Batperson/clock/notes.txt

20/10/2019
There is a high-frequency whine from the audio. This changes in frequency with the length of the
audio sample buffer, so there is likely a glitch when populating the buffer.

There is an audible glitch every 1 seconds, it is caused by the RTC interrupt.

Currently using 150 ohm / 0.1 uF RC low pass filter. HF PWM is attenuated to around 0.1V.

29/10/2019
Implemented button firmware. IDR value is always 1 for all buttons.

02/11/2019
Buttons are working correctly now. Needed to add pull-down resistors even though I specified internal pulldown resistors.

03/11/2019
Implemented a beep routine for button press. This is working but a hard fault occurs if the beep is triggered
by a long button press while a song is playing.

12/11/2019
160 * 128 bare TFT with 14-pin flex connector. Maybe glue directly to outside of enclosure?
Pinout:
1  NC
2  VSS		connect to GND
3  LED-		connect to GND
4  LED+		connect to 3V3 (LED backlight. Resistor needed?)
5  VSS		connect to GND
6  /RESET	reset active low
7  A0		data/command for 4-wire SPI
8  SDA		serial data, MOSI
9  SCK		serial clock
10 VDDA		connect to 3V3 (analog supply)
11 VDDIC	connect to 3V3 (VDDIO? digital supply)
12 /CS		chip select active low
13 VSS		connect to GND
14 NC

13/11/2019
Free shipping to Dec 31 for Element14 with I'MINVITEDFORFREESHIPPING in special instructions/other in delivery options. Order amplifier ICs.
Bomb disarming puzzle in suitcase: https://imgur.com/a/8nmzieA

17/11/2019
Clock set functionality working. Counter does not update immediately.
Next tasks:
* Implement a menu timeout to play an alarm song if the menu option is selected for 1 sec
* Implement a centre-align text render

Audio output has an unpleasant whine. The whine is reduced if LoadSoundBuffer returns early, and goes away entirely if the sound buffer
contains only zeroes. It shows on the oscilloscope as a square wave.
The whine is present on the VCC line so most likely digital noise.
The click which occurs every second when the screen refreshes is also present asa voltage drop on VCC.
The whine is most likely caused by voltage fluctuations which occur as interrupts change the demand for current.
It is mitigated by removing the __WFI() line (i.e. disabling sleep until interrupt) and by placing a 220uF cap
across VCC / GND.

18/11/2019
Now possible to preview an alarm ring by highlighting it in the alarm menu, it will play after 1.5 secs.

26/11/2019
Revised the button system.
Now an issue where the same button events repeat, if the button handlers are changed (e.g. when displaying a menu).
Fixed the button issue.
Seems to be a memory corruption problem, where song state is being overwritten.

30/11/2019
There was no memory corruption, but because I had not declared some variables static but given them the same name across different code units, the linker
made them share the same memory location. Problem is fixed now.

21/12/2019
Most functionality now working. Time and date can be set. Alarm can be set. User must enter an unlock sequence to stop the alarm, this will be an option they can select.
Next tasks to complete:
* The FillMargin flag for DrawText currently assumes text is centred vertically & horizontally
* Special Day messages need to be implemented
* About screen needs to be implemented
* Too much voltage drop causing screen to go dark, and blinking when rendering
* Need to support save/restore of settings in backup domain

23/12/2019
Save/restore settings implemented.
A hard fault is occurring when doing sample playback of alarm rings in the menu. 
Special Days functionality appears to be activating at incorrect times and showing garbage.

24/12/2019
Special Day messages now appearing. Some screen garbage and incorrect colours are likely the result of re-entrancy between the render callback which fires every second
and the special day banner callback which fires every 120ms.

27/12/2019
Re-entrancy issue fixed. Next task is to fix the hard fault when doing sample playback of alarm rings.

03/01/2019
Fully implemented FillMargin behaviour

08/01/2019
Implemented alarm, snooze and no-alarm icons.
Hard fault during sample playback fixed. 
Sometimes, sample playback initiates twice in succession. Sample playback does not start when first showing
the alarm ring menu.

11/01/2019
Fixed the double-playback of alarm rings when previewing in the menu.
Added new ring: Baby Shark.

19/01/2019
Added a few new songs, for use as easter eggs.
Implemented an audio amplifier + speaker, using the TPA2005D1 audio amplifier IC from Texas Instruments. Amplifier shutdown now controlled from pin A2. Unfortunately this creates pop
so it's not possible to switch the amp on and off before playing sounds.
Note intervals now 16 bits long for tied semibreves.
New clipped sine voice, sounds better than boring pure sine tone.

22/01/2019
Next tasks:
* Revamp alarm behaviour. Do not leave alarm mode when snoozing. Make the time flash random coloured stripes and show a ringing bell.
  Long-press any button to snooze.
  Short-press any button to exit alarm mode if alarm lock not set. If set, user must short-press the displayed sequence.
* New menu option: random alarm ring.
* New menu option: adjust the RTC oscillator trim register in case clock is slow or fast.
* New menu option: select display colour.
* New menu option: master volume for alarm ring
* Implement the About screen.   
* Add some more songs. Include Into The Unknown and Star Wars.

27/01/2019
After a song has been stopped, PlaySong does not start a new song playing.

02/02/2020
Finally begun implementing the About screen, which will mostly display a bitmap with a brush effect.
Bitmap is not currently rendering correctly, pixels are skewed.

04/02/2020
About screen now displaying correctly, with a moving gradient brush.
On startup, some random noise gets written to the left and right of the screen. Suspect this may be due to re-entrancy when the display init
routine gets called while the bitmap is already rendering.

08/02/2020
Only one mode now used to set all fields including date, clock, alarm and calibration.
Noticed that switching out of About mode leaves some garbage on the screen.

11/02/2020
Measured current draw. It was 70-80mA with the menu open, and 90 - 120mA with a song playing.

15/02/2020
Ordered cases + laptop speakers, these are on the way.
I wish to control the backlight brightness by PWM. According to this post: https://forum.arduino.cc/index.php?topic=490421.0 this has been done by
using an NPN transistor 2N3904 with a 1k base resistor to ground the cathode of the backlight LEDs.
Or consider using a MOSFET.

16/02/2020
Implemented PWM for backlight using a supposed BS170 N-channel enhancement MOSFET. It is working.

22/02/2020
Clock can now dim its display during night hours, and menu items exist to set night hours, brightness levels and whether or not to dim.

23/02/2020
Replaced the suspect BS170 I was using with a real 2N7000 MOSFET, and the backlight control works much better over the entire PWM range of 0 to 255.
Made some fixes to reflect this and also ensure that the current brightness level is shown when setting the brightness.
Clock is running slow: one clock second appears to be 2+ real seconds.

29/02/2020
Schematic nearly finished. Need to check BOOT0, BOOT1 and also crystal capacitors. Check 3VB battery circuit. 

18/03/2020
Begun layout and routing. Replace the PJ-102 thru-hole barrel jack with SMT equivalent PJ-036AH-SMT-TR or similar.

16/07/2020
Populated 1 circuit board. It is working but had problems with the USB socket which has since peeled off the board. Possible loose connection 
on the programming header pins or cable as sometimes loses power while plugged in. Barrel jacks have not arrived so no alternative power source at present.
Some outstanding bugs: garbage on the screen after exiting the About screen. Seems to enter hard loop after setting date. May need to revisit volume levels for songs.
Need a better New Year message. Need a special build for Rosie with her name on it.

19/07/2020
Populated second board. This one also working, despite the uC not being correctly aligned with the pads and some surgery needed to ensure everything connected with no bridges.
Replaced the USB socket on the first board, both boards now capable of being powered by USB. Noticed some faint background noise from the loudspeaker.

21/07/2020
Implemented fix for special day issue, not tested yet.

08/08/2020
Fixed the issue with garbage appearing on the screen after exiting About mode, by disabling interrupts during rendering. 
Made it so that the screen doesn't flash when operating the menu.
Change to the alarm snooze and lock functionality: if snooze is set then a long press of any button will snooze the alarm.
If no lock is set but snooze mode is on then 3 taps on any button will reset the alarm.
