Batperson/clock/Hardware/3D/SPE_IM120905001_FPC.stp

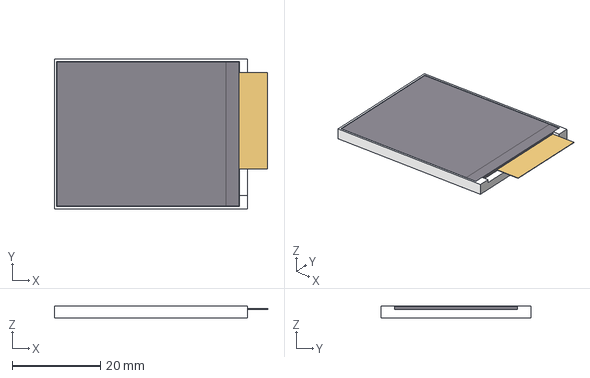
[picture p1: CAD file, 2020-03-28]
Hardware/3D/SPE_IM120905001_FPC.stp
48.4 x 34.0 x 2.75 mm
