Batperson/clock/Models/Front-Panel.dxf

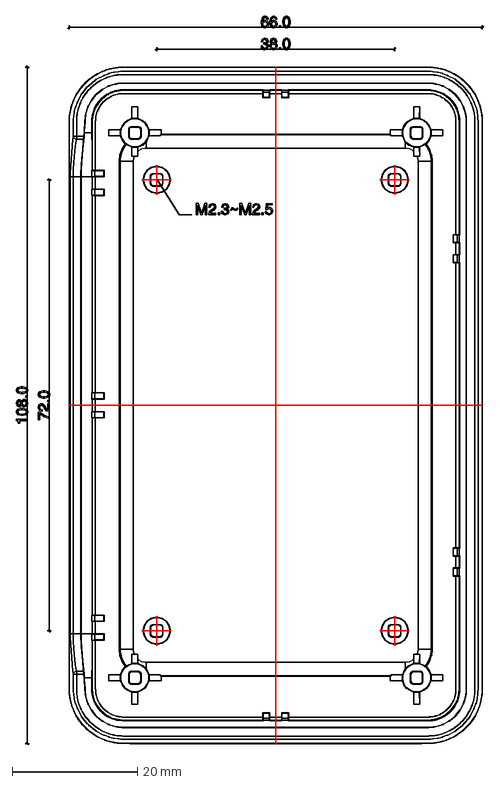
[picture p3: CAD file, 2020-03-13]
Models/Front-Panel.dxf
74.6 x 116.3 mm
