Batperson/clock/Hardware/3D/MSOP-8.step

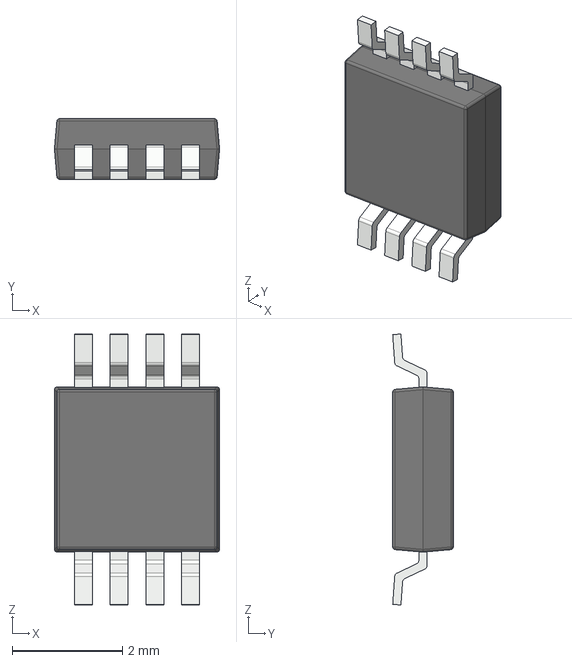
[picture p4: CAD file, 2020-03-21]
Hardware/3D/MSOP-8.step
3.00 x 1.10 x 4.92 mm
