Batperson/clock/Hardware/3D/DC-005-5A-2.5-SMT.stp

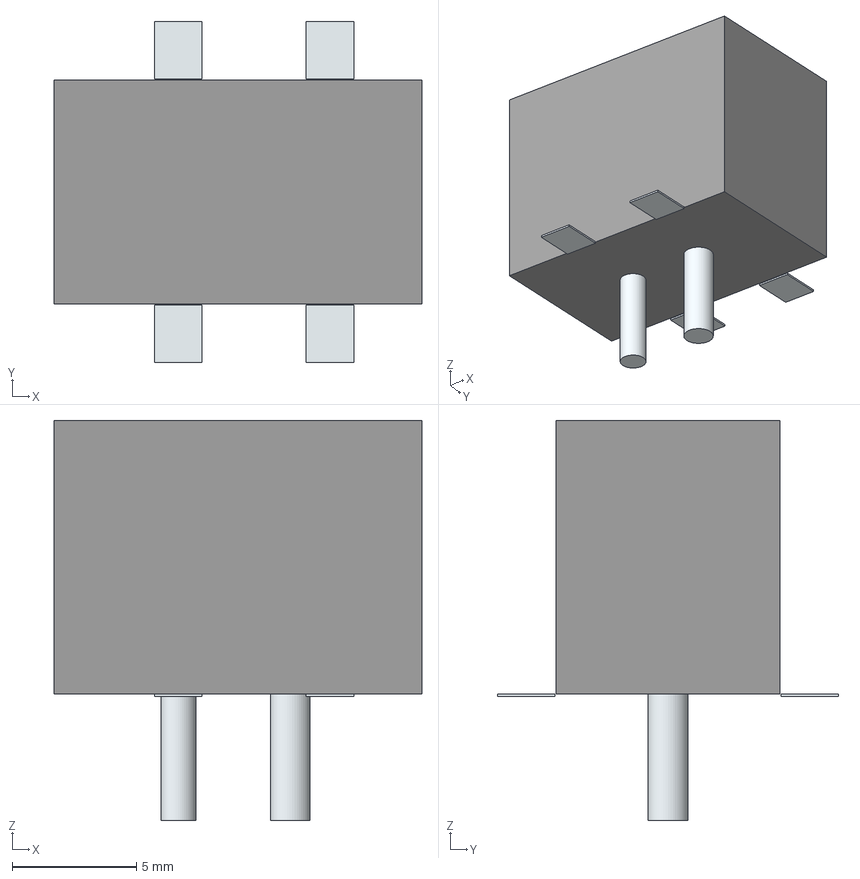
[picture p5: CAD file, 2020-03-21]
Hardware/3D/DC-005-5A-2.5-SMT.stp
14.8 x 13.7 x 16.1 mm
('pin',_'1')
('pin',_'2')
('pin',_'3')
('pin',_'4')
Leads x 2
