Batperson/clock/Hardware/3D/NFE61PT472C1H9L.stp

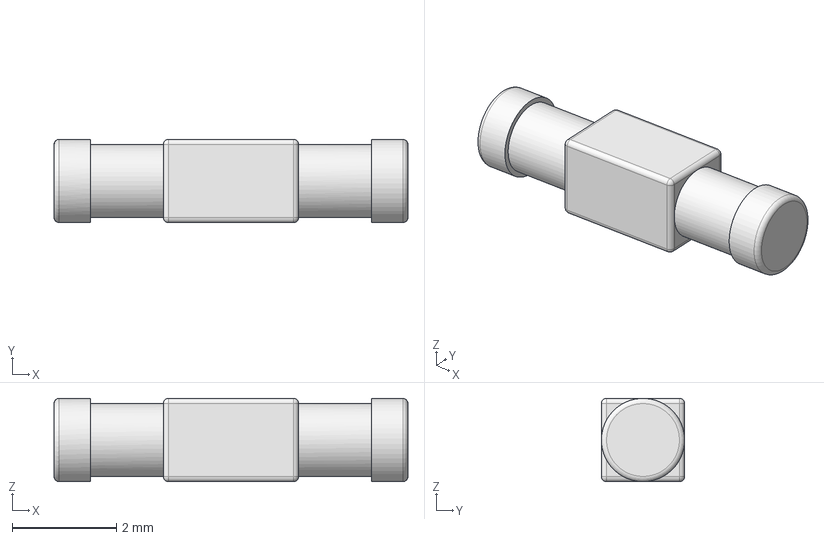
[picture p6: CAD file, 2020-03-15]
Hardware/3D/NFE61PT472C1H9L.stp
6.80 x 1.60 x 1.60 mm
