Batperson/clock/Hardware/3D/PJ-102A.stp

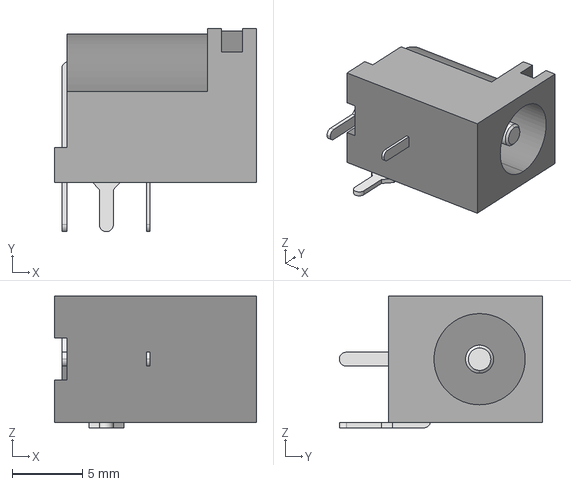
[picture p7: CAD file, 2020-03-13]
Hardware/3D/PJ-102A.stp
14.4 x 14.5 x 9.40 mm
