Batperson/clock/(list of files, cad)

Other CAD files:
Models/BMC 70015.dwg
