Batperson/clock/Hardware/clock.kicad_pcb

## KiCad design Hardware/clock.kicad_pcb (2020-07-15)

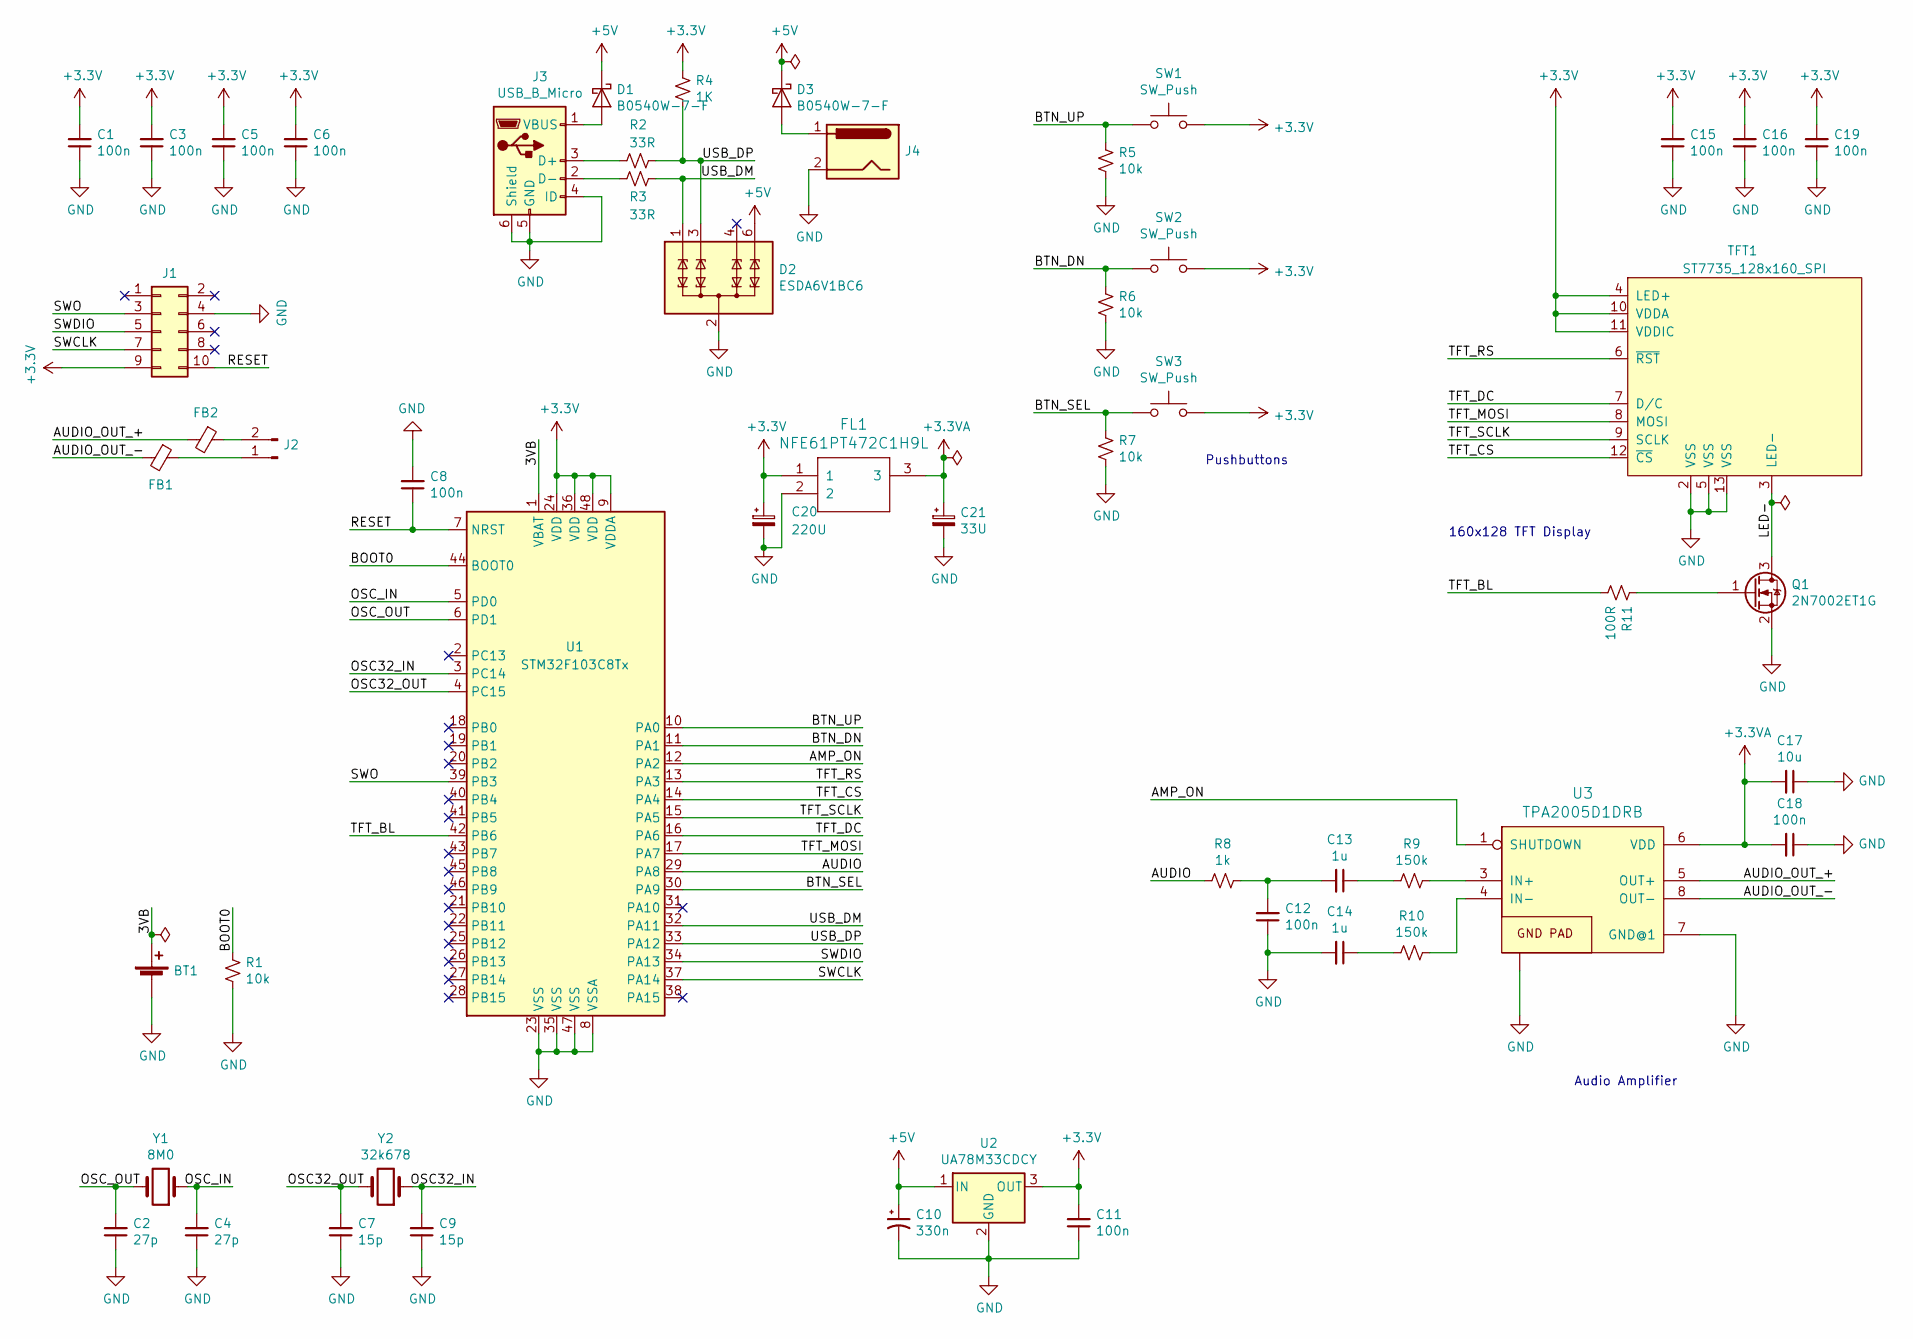
[picture p8: schematic clock.sch, Alarm Clock]

Parts:
BT1: Battery_Cell; BatteryHolder_Keystone_3000_1x12mm
C1, C3, C5, C6, C8, C11, C12, C15, C16, C18, C19: 100n; C_0402_1005Metric
C2, C4: 27p; C_0402_1005Metric
C7, C9: 15p; C_0402_1005Metric
C10: 330n; C_0402_1005Metric
C13, C14: 1u; C_0402_1005Metric
C17: 10u; C_0402_1005Metric
C20: 220U; CP_EIA-7343-20_Kemet-V_Pad2.25x2.55mm_HandSolder
C21: 33U; CP_EIA-3528-21_Kemet-B_Pad1.50x2.35mm_HandSolder
D1, D3: B0540W-7-F; D_SOD-123
D2: ESDA6V1BC6; SOT-23-6
FB1, FB2: BLM18PG471SN1D; R_0603_1608Metric_Pad1.05x0.95mm_HandSolder
FL1: NFE61PT472C1H9L; 6816
J1: Conn_02x05_Counter_Clockwise; PinHeader_2x05_P2.54mm_Vertical
J2: Conn_01x02_Male; PinHeader_1x02_P2.54mm_Horizontal
J3: USB_B_Micro; USB_Micro-B_Molex_47346-0001
J4: Barrel_Jack; DC-005-SMT
Q1: 2N7002ET1G; SOT-23_Handsoldering
R1, R5, R6, R7: 10k; R_0603_1608Metric
R2, R3: 33R; R_0603_1608Metric
R4: 1K; R_0603_1608Metric
R8: 1k; R_0603_1608Metric
R9, R10: 150k; R_0603_1608Metric
R11: 100R; R_0603_1608Metric
SW1, SW2, SW3: SW_Push; SW_Push_1P1T_NO_6x6mm_H9.5mm
TFT1: ST7735_128x160_SPI; TFT_160x120_14pin
U1: STM32F103C8Tx; LQFP-48_7x7mm_P0.5mm
U2: UA78M33CDCY; SOT-223-3_TabPin2
U3: TPA2005D1DRB; MSOP-8-1EP_3x3mm_P0.65mm_EP1.73x1.85mm
Y1: 8M0; Crystal_HC49-U_Vertical
Y2: 32k678; Crystal_SMD_3215-2Pin_3.2x1.5mm

Connections:
+3.3VA: C17.2, C18.2, C21.1, FL1.3, U3.6 (VDD)
+3V3: C1.2, C3.2, C5.2, C6.2, C11.2, C15.2, C16.2, C19.2, C20.1, FL1.1, J1.9, R4.2, SW1.2, SW2.2, SW3.2, TFT1.4 (LED+), TFT1.10 (VDDA), TFT1.11 (VDDIC), U1.9 (VDDA), U1.24 (VDD), U1.36 (VDD), U1.48 (VDD), U2.3 (OUT)
+5V: C10.1, D1.1 (K), D2.6 (TVS4), D3.1 (K), U2.1 (IN)
/3VB: BT1.1 (+), U1.1 (VBAT)
/AMP_ON: U1.12 (PA2), U3.1 (SHUTDOWN)
/AUDIO: R8.2, U1.29 (PA8)
/AUDIO_OUT_+: FB2.2, U3.5 (OUT+)
/AUDIO_OUT_-: FB1.2, U3.8 (OUT-)
/BOOT0: R1.2, U1.44 (BOOT0)
/BTN_DN: R6.2, SW2.1, U1.11 (PA1)
/BTN_SEL: R7.2, SW3.1, U1.30 (PA9)
/BTN_UP: R5.2, SW1.1, U1.10 (PA0)
/LED-: Q1.3 (D), TFT1.3 (LED-)
/OSC32_IN: C9.2, U1.3 (PC14), Y2.1
/OSC32_OUT: C7.2, U1.4 (PC15), Y2.2
/OSC_IN: C4.2, U1.5 (PD0), Y1.1
/OSC_OUT: C2.2, U1.6 (PD1), Y1.2
/RESET: C8.1, J1.10, U1.7 (NRST)
/SWCLK: J1.7, U1.37 (PA14)
/SWDIO: J1.5, U1.34 (PA13)
/SWO: J1.3, U1.39 (PB3)
/TFT_BL: R11.1, U1.42 (PB6)
/TFT_CS: TFT1.12 (~CS), U1.14 (PA4)
/TFT_DC: TFT1.7 (D/C), U1.16 (PA6)
/TFT_MOSI: TFT1.8 (MOSI), U1.17 (PA7)
/TFT_RS: TFT1.6 (~RST), U1.13 (PA3)
/TFT_SCLK: TFT1.9 (SCLK), U1.15 (PA5)
/USB_DM: D2.1 (TVS1), R3.2, U1.32 (PA11)
/USB_DP: D2.3 (TVS2), R2.2, R4.1, U1.33 (PA12)
GND: BT1.2 (-), C1.1, C2.1, C3.1, C4.1, C5.1, C6.1, C7.1, C8.2, C9.1, C10.2, C11.1, C12.1, C14.2, C15.1, C16.1, C17.1, C18.1, C19.1, C20.2, C21.2, D2.2 (COM), D2.5 (COM), FL1.2, J1.4, J3.4 (ID), J3.5 (GND), J3.6 (Shield), J4.2, Q1.2 (S), R1.1, R5.1, R6.1, R7.1, TFT1.2 (VSS), TFT1.5 (VSS), TFT1.13 (VSS), U1.8 (VSSA), U1.23 (VSS), U1.35 (VSS), U1.47 (VSS), U2.2 (GND), U3.7 (GND@1), U3.9 (GND@2)
unnamed: C12.2, C13.2, R8.1
unnamed: C13.1, R9.2
unnamed: C14.1, R10.2
unnamed: D1.2 (A), J3.1 (VBUS)
unnamed: D3.2 (A), J4.1
unnamed: FB1.1, J2.1
unnamed: FB2.1, J2.2
unnamed: J3.2 (D-), R3.1
unnamed: J3.3 (D+), R2.1
unnamed: Q1.1 (G), R11.2
unnamed: R9.1, U3.3 (IN+)
unnamed: R10.1, U3.4 (IN-)

Notes on the sheet:
Audio Amplifier
160x128 TFT Display
Pushbuttons

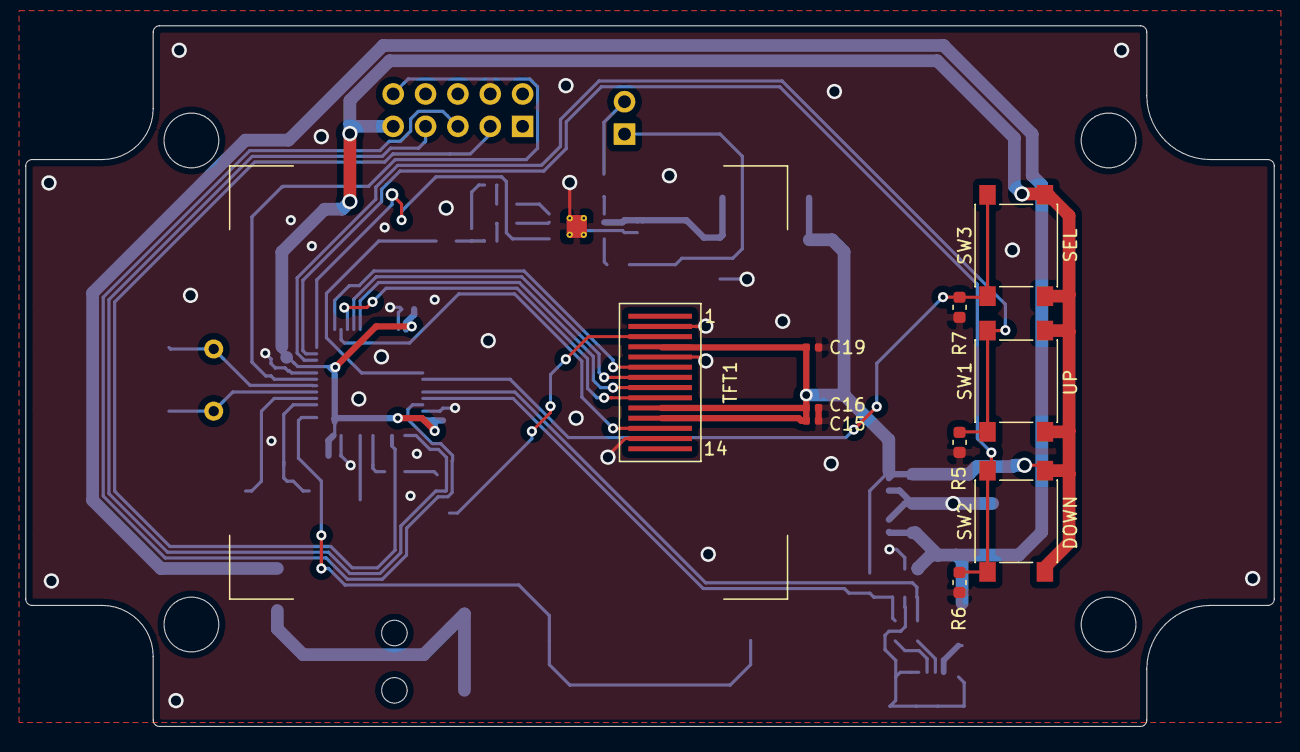
[picture p9: board clock.kicad_pcb from above]

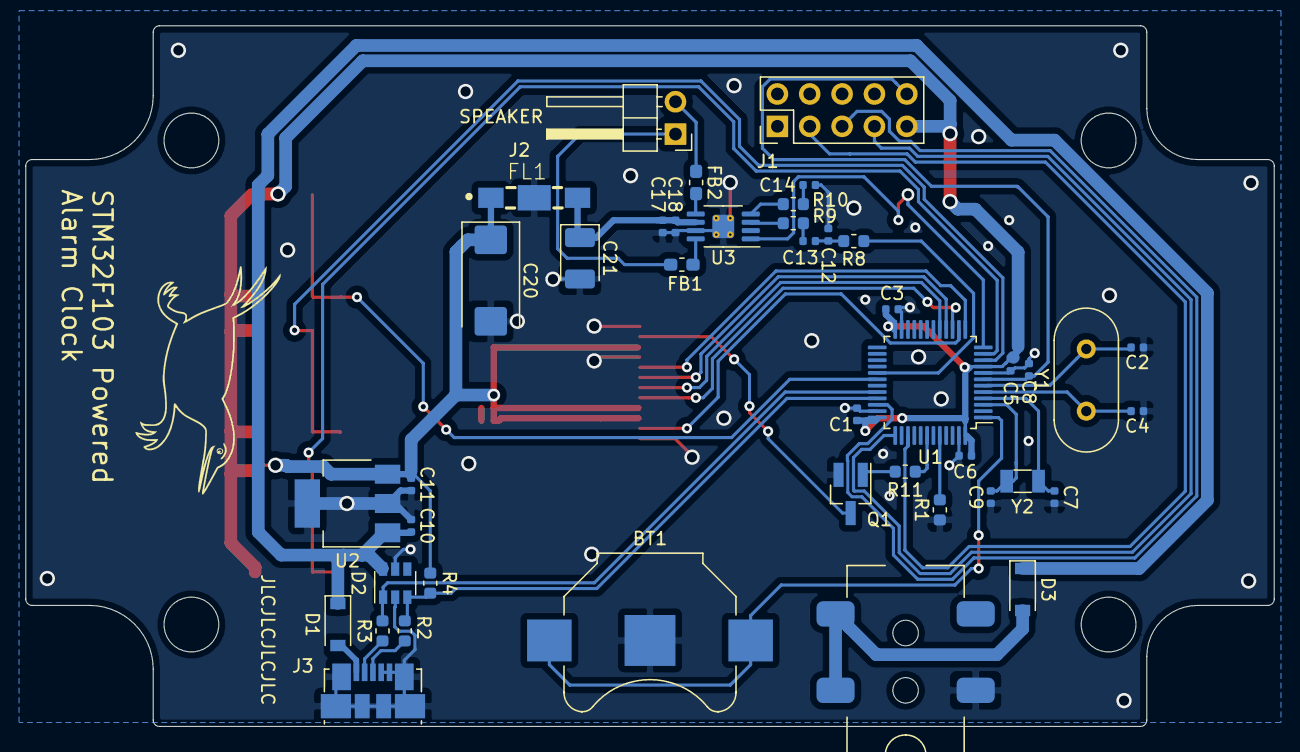
[picture p10: board clock.kicad_pcb from below]

Board: 2 copper layers, 98.0 x 55.0 mm, 53 parts (43 on the bottom side), 42 nets.
