Batperson/clock/src/about_bmp.c

/*
 * about_bmp.c
 *
 *  Created on: 2/02/2020
 */

#include "stm32f10x.h"
#include "macros.h"
#include "graphics.h"

//
//  Image data for about, 160 * 103
//

const uint8_t bitmapData[] =
{
	0x00, 0x06, 0x00, 0x00, 0x60, 0x10, 0x00, 0x07, 0x80, 0x00, 0x00, 0x1E, 0x00, 0x00, 0x00, 0xC0, //              ##                  ##        #                 ####                          ####                         ##
	0xFC, 0x06, 0x00, 0x00, 0x60, 0x30, 0x00, 0x01, 0x80, 0x00, 0x1E, 0x06, 0x00, 0x00, 0x00, 0xC0, // ######       ##                  ##       ##                   ##                  ####      ##                         ##
	0xFE, 0x00, 0x00, 0x00, 0x00, 0x30, 0x00, 0x01, 0x80, 0x00, 0x7F, 0x06, 0x00, 0x00, 0x00, 0xC0, // #######                                   ##                   ##                #######     ##                         ##
	0xC7, 0x1E, 0x03, 0xF1, 0xE0, 0xFF, 0x1F, 0x01, 0x80, 0x00, 0x60, 0x06, 0x03, 0xC0, 0x78, 0xC7, // ##   ###   ####       ######   ####     ########   #####       ##                ##          ##       ####       ####   ##   ###
	0xC3, 0x1E, 0x07, 0xF1, 0xE0, 0xFF, 0x1F, 0x81, 0x80, 0x00, 0xC0, 0x06, 0x07, 0xF1, 0xF8, 0xCE, // ##    ##   ####      #######   ####     ########   ######      ##               ##           ##      #######   ######   ##  ###
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
};

const Bitmap aboutB = {
	128,
	104,
	Colour1Bpp,
	(void*)bitmapData
};

const Bitmap* about 			= &aboutB;
