Batperson/clock/src/voices.c

/*
 * instruments.c
 *
 *  Created on: 6/10/2019
 */
#include "stm32f10x.h"
#include "sound.h"

Voice sine =
{
	255,
	128,
	{
		0x00,
		0x03,
		0x06,
		0x09,
		0x0C,
		0x10,
		0x13,
		0x16,
		0x19,
		0x1C,
		0x1F,
		0x22,
		0x25,
		0x28,
		0x2B,
		0x2E,
		0x31,
		0x33,
		0x36,
		0x39,
		0x3C,
		0x3F,
		0x41,
		0x44,
		0x47,
		0x49,
		0x4C,
		0x4E,
		0x51,
		0x53,
		0x55,
		0x58,
		0x5A,
		0x5C,
		0x5E,
		0x60,
		0x62,
		0x64,
		0x66,
		0x68,
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
	}
};

Voice saw = {
	256,
	128,
	{
		0x80,
		0x81,
		0x82,
		0x83,
		0x84,
		0x85,
		0x86,
		0x87,
		0x88,
		0x89,
		0x8A,
		0x8B,
		0x8C,
		0x8D,
		0x8E,
		0x8F,
		0x90,
		0x91,
		0x92,
		0x93,
		0x94,
		0x95,
		0x96,
		0x97,
		0x98,
		0x99,
		0x9A,
		0x9B,
		0x9C,
		0x9D,
		0x9E,
		0x9F,
		0xA0,
		0xA1,
		0xA2,
		0xA3,
		0xA4,
		0xA5,
		0xA6,
		0xA7,
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
	}
};

Voice clipped = {
	255,
	128,
	{
		0x00,
		0x04,
		0x08,
		0x0D,
		0x11,
		0x15,
		0x19,
		0x1D,
		0x21,
		0x25,
		0x29,
		0x2D,
		0x31,
		0x35,
		0x39,
		0x3D,
		0x41,
		0x45,
		0x49,
		0x4C,
		0x50,
		0x54,
		0x57,
		0x5B,
		0x5E,
		0x62,
		0x65,
		0x69,
		0x6C,
		0x6F,
		0x72,
		0x75,
		0x78,
		0x7B,
		0x7E,
		0x7F,
		0x7F,
		0x7F,
		0x7F,
		0x7F,
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
	}
};
