Batperson/clock/src/song.c

/*
 * song.c
 *
 *  Created on: 13/10/2019
 */

#include <stdio.h>
#include <string.h>
#include "stm32f10x.h"
#include "macros.h"
#include "system.h"
#include "sound.h"
#include "song.h"

#define FLAGS_PLAYING	0x80
#define INTERVAL_TO_TICKS(intv) (uint16_t)((TICKS_PER_BEAT * 4) / intv)

typedef enum
{
	None		= 0x00,
	Active		= 0x01,
} TrackFlags;

typedef struct
{
	TrackFlags	flags;
	uint16_t 	note;
	uint16_t	ticks;
} TrackState, *PTrackState;

typedef struct
{
	PSong		song;
	uint16_t 	tempo;
	PlayFlags	flags;
	TrackState track[SOUND_CHANNELS];
} SongState;

static volatile SongState state;

void InitSong()
{
	TIM_TimeBaseInitTypeDef		timb;
	NVIC_InitTypeDef 			nvic;

	RCC_APB1PeriphClockCmd(RCC_APB1Periph_TIM3, ENABLE);

	TIM_TimeBaseStructInit(&timb);

	timb.TIM_Prescaler 			= (SystemCoreClock /*/2 */) / 1000000;	// Clock ticks at 1MHz
	timb.TIM_CounterMode 		= TIM_CounterMode_Up;
	timb.TIM_Period 			= 1000;
	timb.TIM_ClockDivision 		= TIM_CKD_DIV1;
	timb.TIM_RepetitionCounter 	= 0;
	TIM_TimeBaseInit(TIM3, &timb);
	TIM_ClearITPendingBit(TIM3, TIM_IT_Update);
	TIM_ITConfig(TIM3, TIM_IT_Update, ENABLE);

	nvic.NVIC_IRQChannel 					= TIM3_IRQn;
	nvic.NVIC_IRQChannelPreemptionPriority 	= 1;
	nvic.NVIC_IRQChannelSubPriority 		= 0;
	nvic.NVIC_IRQChannelCmd 				= ENABLE;
	NVIC_Init(&nvic);

	memset((SongState*)&state, 0, sizeof(SongState));

	printf("Song player initialized\n");
}

void SetTempo(uint16_t bpm)
{
	state.tempo = bpm;

	// 1MHz, divided by (beats per second * TICKS_PER_BEAT)
	TIM_SetAutoreload(TIM3, (1000000 / ((bpm * TICKS_PER_BEAT) / 60))- 1);
}

void IncrementTempo(uint16_t bpm)
{
	SetTempo(state.tempo + bpm);
}

void InitTracks()
{
	for(int i=0; i<SOUND_CHANNELS; i++)
	{
		SoundOff(i);
		memset((PTrackState)&state.track[i], 0, sizeof(TrackState));
	}

	for(int i=0; i<SOUND_CHANNELS; i++)
	{
		PTrackState ts 	= (PTrackState)&state.track[i];
		PTrack t		= state.song->tracks[i];

		if(t == NULL)
			break;

		ts->ticks 	= state.song->tickOffset[i];
		ts->flags 	|= Active;
		SelectVoice(i, t->volume, t->voice);
	}
}

void SelectSong(PSong song)
{
	state.song = song;

	SetTempo(song->bpm);

	InitTracks();
}

void PlaySong(PlayFlags flags)
{
	AudioOn();

	state.flags		= flags | FLAGS_PLAYING;

	TIM_Cmd(TIM3, ENABLE);
}

void PauseSong()
{
	AudioOff();

	TIM_Cmd(TIM3, DISABLE);

	for(int i=0; i< SOUND_CHANNELS; i++)
		SoundOff(i);
}

void WEAKREF OnSongEnd()
{

}

void WEAKREF OnTrackEnd(int track)
{

}

void EndSong()
{
	if(state.flags & FLAGS_PLAYING)
	{
		TIM_Cmd(TIM3, DISABLE);
		TIM_ClearITPendingBit(TIM3, TIM_IT_Update);

		state.flags &= ~FLAGS_PLAYING;

		if(state.song != NULL)
			InitTracks();

		OnSongEnd();
		AudioOff();
	}
}

void INTERRUPT TIM3_IRQHandler()
{
	TIM3->SR		&= ~TIM_SR_UIF;

	uint8_t atracks	= 0;

	for(int i=0; i < SOUND_CHANNELS; i++)
	{
		PTrackState ts 	= (PTrackState)&state.track[i];
		PTrack t		= state.song->tracks[i];

		if(ts->flags & Active)
		{
			atracks++;
			if(ts->ticks-- == 0)
			{
				PNote n		= &t->notes[ts->note++];
				if(n->interval == 0 && n->pitch == 0)
				{
					// Track ends
					ts->flags			= None;
					atracks--;

					SoundOff(i);
					OnTrackEnd(i);
				}
				else
				{
					ts->ticks			= n->interval-1;

					if(n->pitch > 0)
						SoundOn(i, n->pitch);
					else
						SoundOff(i);

					ITM->PORT[1].u32	= n->pitch;
					ITM->PORT[2].u8		= ts->ticks;
				}
			}
			else if(ts->ticks == t->legato)
			{
				SoundOff(i);
			}
		}
	}

	if(atracks == 0)
	{
		if(state.flags & PlayLoop)
			InitTracks();
		else
			EndSong();
	}
}
