Batperson/clock/inc/menu.h

/*
 * menu.h
 *
 *  Created on: 10/11/2019
 */

#ifndef MENU_H_
#define MENU_H_

#define MENU_TIMEOUT_MILLIS			1500
#define MAX_RENDER_MENU_ITEMS		12

typedef void (*PMenuProc)(uint32_t);

typedef enum {
	MenuNone		= 0x00,
	MenuSelected	= 0x01
} MenuFlags;

typedef struct {
	char* 					text;
	void*					proc;
	uint32_t				arg;
	MenuFlags				flags;
} MenuItem, *PMenuItem;

void MenuUp();
void MenuDown();
void MenuSelect();
void RenderMenu();
void SetCurrentMenu(PMenuItem);
void GetMenuState(uint8_t* menuIndex, uint8_t* menuLength, PMenuItem* currentMenu);

#endif /* MENU_H_ */
