Batperson/clock/inc/songs.h

/*
 * songs.h
 *
 *  Created on: 22/12/2019
 */

#ifndef SONGS_H_
#define SONGS_H_

extern Song arpeggiator;
extern Song reveille;
extern Song bbshark;
extern Song gravity;
extern Song birthday;
extern Song anthem;
extern Song starwars;
extern Song unknown;

#endif /* SONGS_H_ */
