Batperson/clock/inc/macros.h

/*
 * misc.h
 * Utility defines
 */

#ifndef MISC_H_
#define MISC_H_

// use #ifdef __CDT_PARSER__ if necessary to hide constructs from the indexer

#define IN_ROM				__attribute__ ((section (".rodata")))
#define IN_RAM  			__attribute__((section(".data")))
#define ALIGNED(n) 			__attribute__((aligned(n)))
#define INTERRUPT 			__attribute__((interrupt("IRQ")))
#define WEAKREF				__attribute__((weak))
#define ALWAYS_INLINE 		inline __attribute__((always_inline))

#define ITM_Port8(n)    (*((volatile unsigned char *)(0xE0000000+4*n)))
#define ITM_Port16(n)   (*((volatile unsigned short*)(0xE0000000+4*n)))
#define ITM_Port32(n)   (*((volatile unsigned long *)(0xE0000000+4*n)))

#define ROL(val, shift) ((val<<shift) | (val>>(-shift&31)))
#define ROR(val, shift) ((val>>shift) | (val<<(-shift&31)))

#define		MIN_SIGNED_SHORT	-32768
#define		MAX_SIGNED_SHORT	32767

#endif /* MISC_H_ */
