Batperson/clock/src/instruments.c

/*
 * instruments.c
 *
 *  Created on: 6/10/2019
 */
#include "stm32f10x.h"
#include "sound.h"

Wave sine =
{
	{
		0x80,
		0x83,
		0x86,
		0x89,
		0x8C,
		0x90,
		0x93,
		0x96,
		0x99,
		0x9C,
		0x9F,
		0xA2,
		0xA5,
		0xA8,
		0xAB,
		0xAE,
		0xB1,
		0xB3,
		0xB6,
		0xB9,
		0xBC,
		0xBF,
		0xC1,
		0xC4,
		0xC7,
		0xC9,
		0xCC,
		0xCE,
		0xD1,
		0xD3,
		0xD5,
		0xD8,
		0xDA,
		0xDC,
		0xDE,
		0xE0,
		0xE2,
		0xE4,
		0xE6,
		0xE8,
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
	}
};
