Batperson/clock/(commit log)

2019-10-28 Implemented button firmware
2019-11-02 Button firmware working
2019-11-08 Clock state framework, reorganization
2019-11-17 The same track can be layered more than once, with a tempo offset
2019-11-26 Revised the button callback system
2019-11-26 Fix issue where multiple button down events occurred with only 1 button press.
    [button.c, main.c]
2019-11-26 More button fixes
2019-11-30 Revised button handlers again. Now support multiple events per handler. Can hold button down to quickly increment or decrement a value when setting time, date or alarm.
2019-11-30 Fix issue where multiple events occur after changing the button handler
    [button.c]
2019-12-26 Replace roll-my-own swap function with CMSIS version
    [st7735.c]
2019-12-26 Fixed re-entrancy issue with special day messages
    [graphics.c, graphics.h, render.c]
2020-01-11 Fixed double-start of alarm rings when previewing with the menu.
    [main.c, menu.c]
2020-01-18 Added amplifier shutdown pin A2
2020-01-25 Started on hardware schematic + board design.
    [clock.kicad_pcb, clock.sch]
2020-01-25 Added MCU, amplifier to schematic.
2020-01-26 Fixed a bad note definition. More of Into The Unknown.
    [main.c, song.h, songs.c]
2020-02-02 Fixed issue with DrawBitmap. About screen now rendering. Implemented gradient brush.
    [about_bmp.c, graphics.c, graphics_impl.h, main.c, render.c, st7735.c]
2020-02-06 Song tweaks, implementation of oscillator calibration and snooze minutes menu options
    [clock.h, main.c, render.c, rtc.c, rtc.h, songs.c]
2020-02-08 Fix one song title which was too long
    [main.c]
2020-02-16 Implemented backlight PWM brightness control
2020-02-21 Changes to schematic. Implemented display dimming and menu items to control dimming.
    [clock.sch]
2020-02-22 Small fixes to brightness control
    [clock.h, main.c]
2020-02-22 Another fix to brightness settings
    [main.c]
2020-02-28 Updated schematic
    [clock.sch]
2020-03-13 Finished schematic. Begun routing. Added enclosure design files from vendor.
    [BMC 70015.dwg, Front-Panel.dxf, PJ-102A.stp, clock.kicad_pcb, clock.sch]
2020-03-15 Added filter for amplifier supply. Some routing.
    [NFE61PT472C1H9L.stp, clock.kicad_pcb, clock.sch]
2020-03-21 Routing complete
    [DC-005-5A-2.5-SMT.stp, MSOP-8.step, clock.kicad_pcb, clock.sch]
2020-03-24 DC jack was round the wrong way. Added proper step model for it. Added Freecad model.
    [CUI_DEVICES_PJ-002AH-SMT-TR.step, clock.kicad_pcb]
2020-03-28 Added FreeCAD model of enclosure + PCB. Small changes to PCB layout. Added STEP model of TFT display.
    [SPE_IM120905001_FPC.stp, clock.csv, clock.kicad_pcb, clock.sch]
2020-03-28 Added weka to silkscreen.
    [clock.kicad_pcb]
2020-07-15 Small changes to code after populating board. Hardware should be unchanged.
    [clock-B_Cu.gbr, clock-B_Mask.gbr, clock-B_SilkS.gbr, clock-Edge_Cuts.gbr, clock-F_Cu.gbr, clock-F_Mask.gbr, clock-F_SilkS.gbr, clock.drl]
2020-07-21 Untested fix for crash which occurs when setting the date if the special day text is showing.
    [clock.h, main.c, render.c]
2020-08-02 Amp is disabled when no sound playing, to avoid annoying whine. Fixed crash when selecting Random Song menu item. Workaround for misaligned screen. New build for Rosie, with specific special days.
    [button.c, main.c, render.c, song.c, sound.c]
2020-08-02 Fix for alarm ring not playing
    [main.c, sound.c]
2020-08-04 Added quick way to skip through special day texts
    [clock.h, main.c, render.c]
2020-08-07 Fix for screen garbage when exiting About screen. Running out of memory so removed the lowercase letters from sysFont. Change to alarm snooze functionality. Misc. fixes.
    [main.c, menu.c, render.c]
2020-08-09 Date and render fixes
    [main.c, render.c]
